freznel10/Chunky2040_rev2/Main Outline.dxf

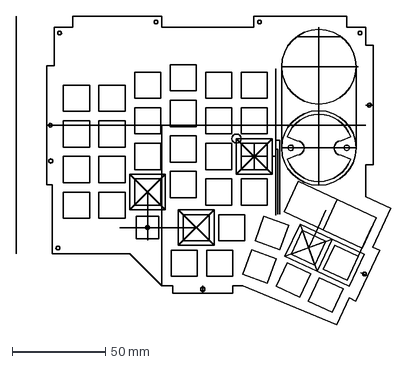
[picture p1: CAD file, 2023-04-12]
Main Outline.dxf
200.7 x 165.2 mm
