freznel10/Chunky2040_rev2/Assembly_final/Switch_Plate_Final.dxf

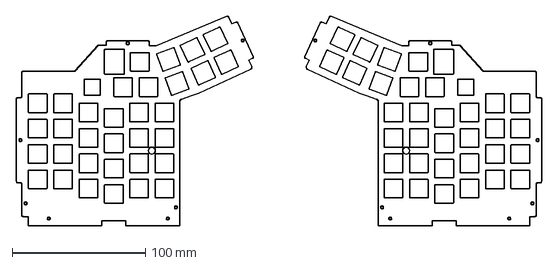
[picture p2: CAD file, 2023-04-12]
Assembly_final/Switch_Plate_Final.dxf
394.5 x 157.6 mm
