freznel10/Chunky2040_rev2/Assembly_final/Top_Right.step

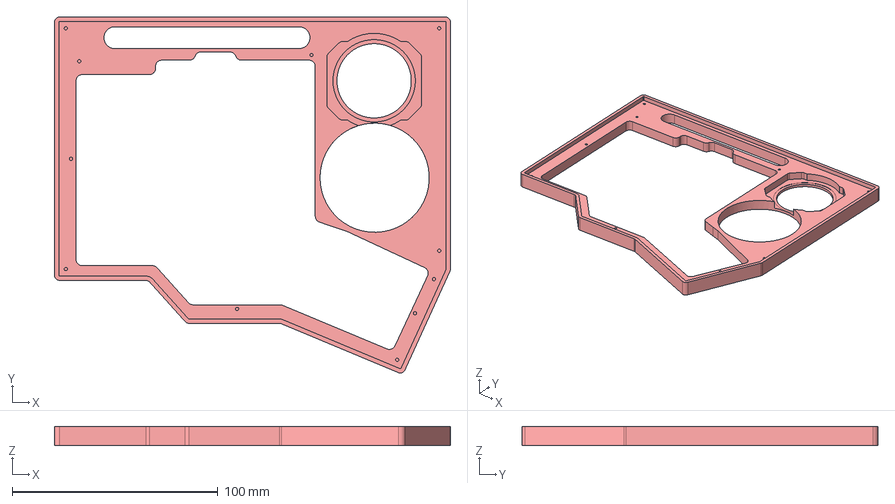
[picture p3: CAD file, 2023-04-12]
Assembly_final/Top_Right.step
192.3 x 172.8 x 9.30 mm
