freznel10/Chunky2040_rev2/SK8707-51.dxf

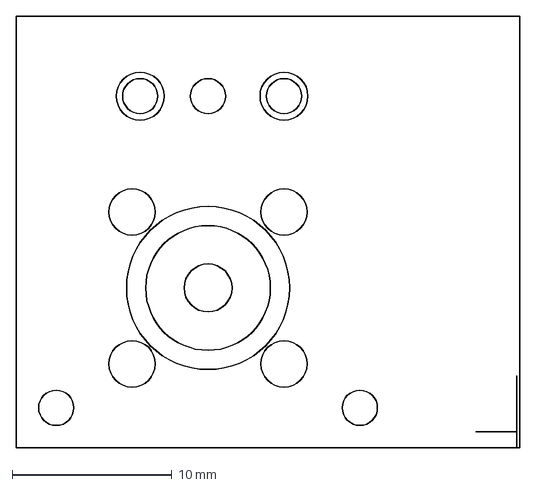
[picture p4: CAD file, 2023-04-12]
SK8707-51.dxf
31.5 x 27.0 mm
