freznel10/Chunky2040_rev2/Assembly_final/Bottom_Right.step

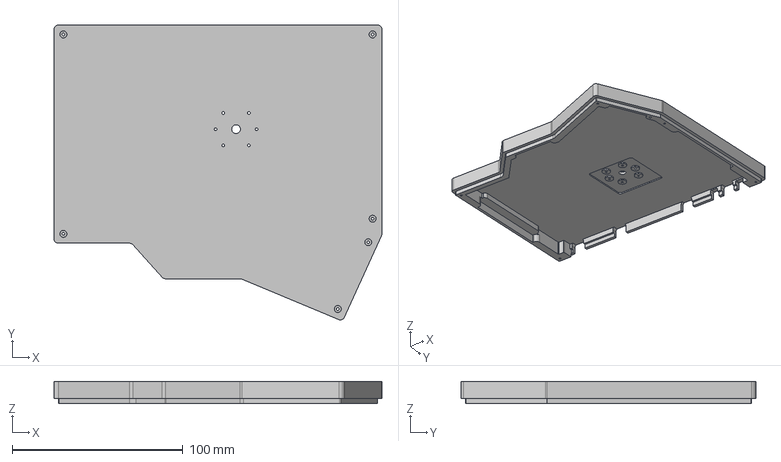
[picture p5: CAD file, 2023-04-12]
Assembly_final/Bottom_Right.step
192.3 x 172.8 x 13.1 mm
