freznel10/Chunky2040_rev2/Edge Cuts_v10.dxf

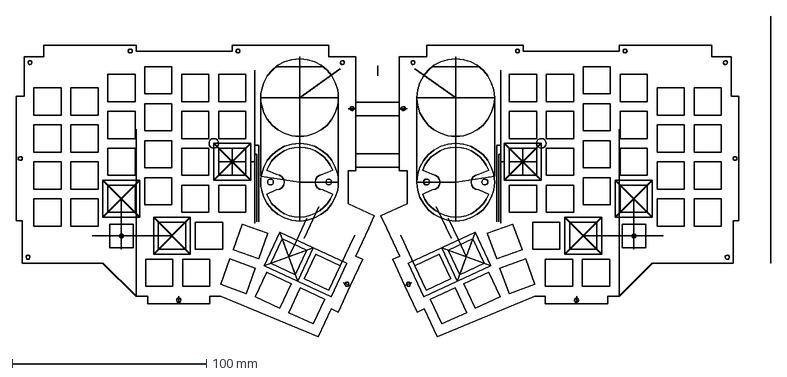
[picture p6: CAD file, 2023-04-12]
Edge Cuts_v10.dxf
388.5 x 165.2 mm
