freznel10/Chunky2040_rev2/Edge_Cuts_v6.dxf

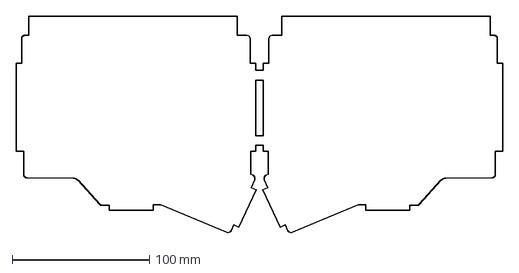
[picture p7: CAD file, 2023-04-12]
Edge_Cuts_v6.dxf
354.2 x 157.8 mm
