freznel10/Chunky2040_rev2/Badge_Sensor.dxf

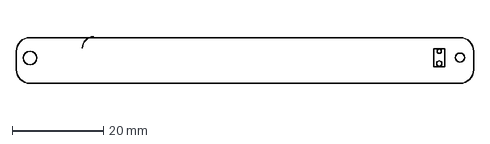
[picture p8: CAD file, 2023-04-12]
Badge_Sensor.dxf
100.0 x 10.2 mm
