freznel10/Chunky2040_rev2/GC9A01 v1.step

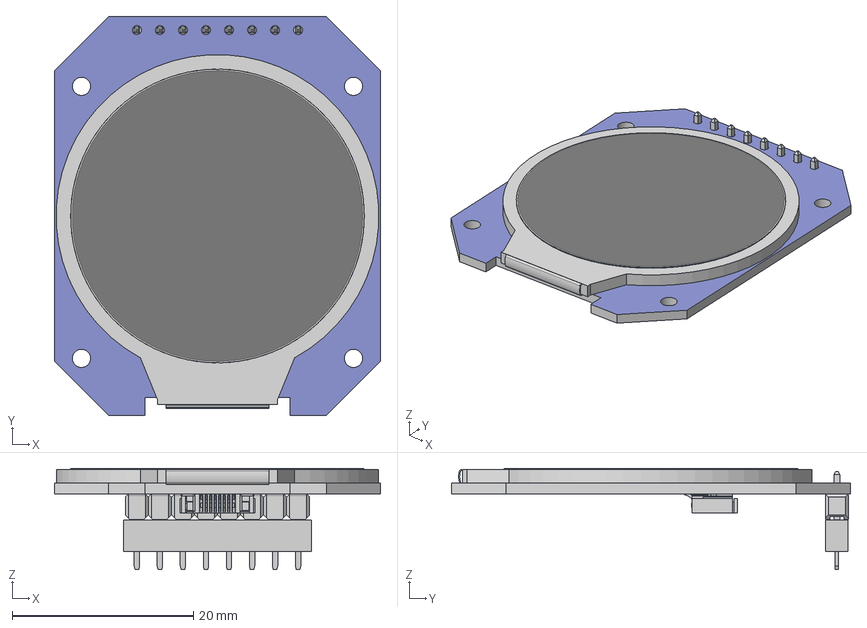
[picture p9: CAD file, 2023-04-12]
GC9A01 v1.step
36.0 x 44.0 x 11.2 mm
Header Socket 8-way v1
Pin Header 1x8 TH Pitch 2.54mm v1
FPC-8 v1 (1)
Screen1
Screen2
Screen Body (1)
