freznel10/Chunky2040_rev2/Edge_Guide_Scroll.dxf

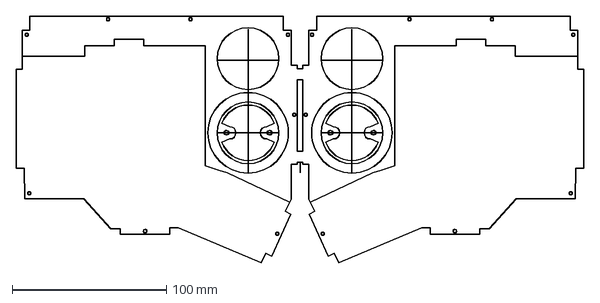
[picture p10: CAD file, 2023-04-12]
Edge_Guide_Scroll.dxf
368.2 x 159.8 mm
