freznel10/Chunky2040_rev2/T16_Scroll Wheel.step

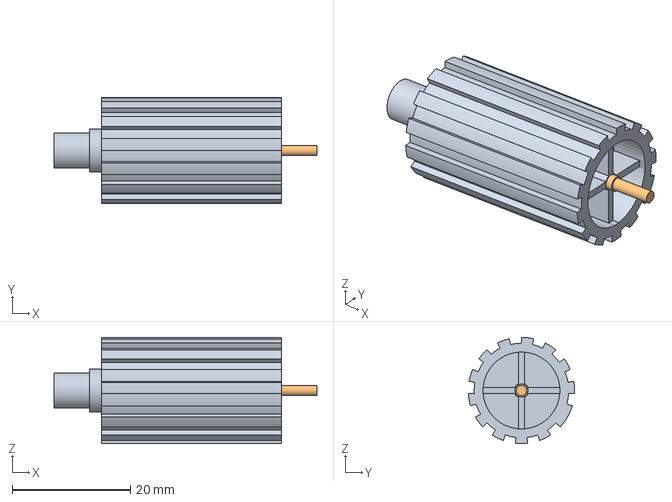
[picture p11: CAD file, 2023-04-12]
T16_Scroll Wheel.step
44.5 x 18.0 x 18.0 mm
