freznel10/Chunky2040_rev2/Switch.dxf

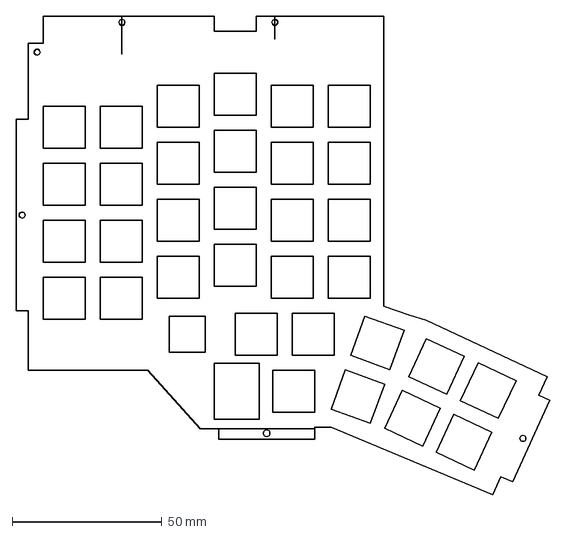
[picture p12: CAD file, 2023-04-12]
Switch.dxf
178.2 x 159.8 mm
