freznel10/Chunky2040_rev2/Fit Test.dxf

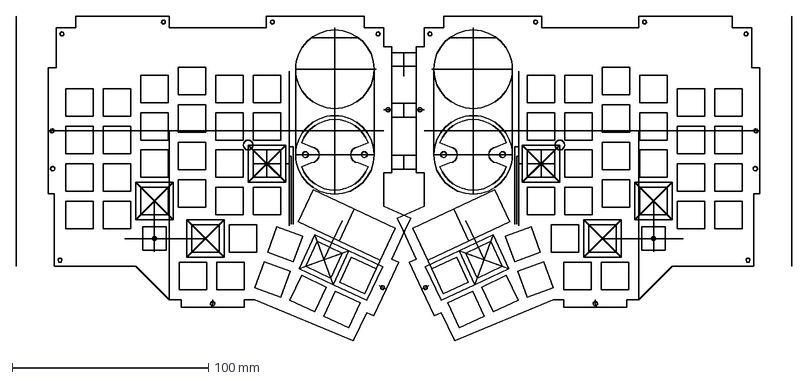
[picture p13: CAD file, 2023-04-12]
Fit Test.dxf
394.8 x 165.2 mm
