freznel10/Chunky2040_rev2/D65 gasket.dxf

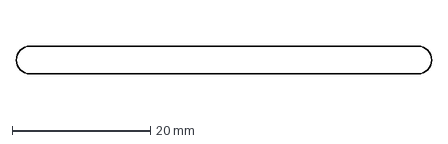
[picture p14: CAD file, 2023-04-12]
D65 gasket.dxf
60.0 x 4.00 mm
