freznel10/Chunky2040_rev2/Cover_Guide.dxf

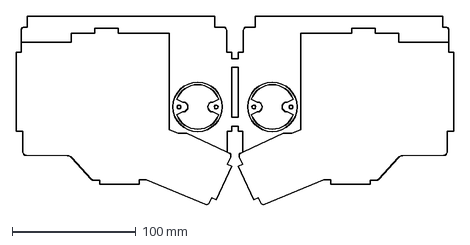
[picture p15: CAD file, 2023-04-12]
Cover_Guide.dxf
354.2 x 152.8 mm
