freznel10/Chunky2040_rev2/Outline_2.dxf

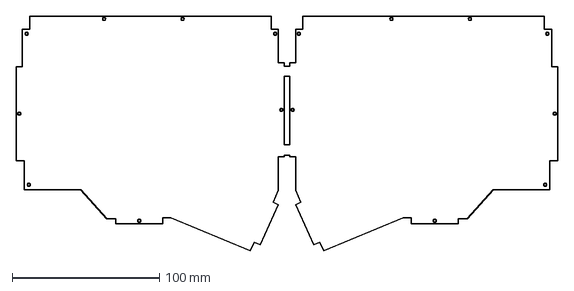
[picture p16: CAD file, 2023-04-12]
Outline_2.dxf
368.2 x 159.8 mm
