freznel10/Chunky2040_rev2/Final Outline.dxf

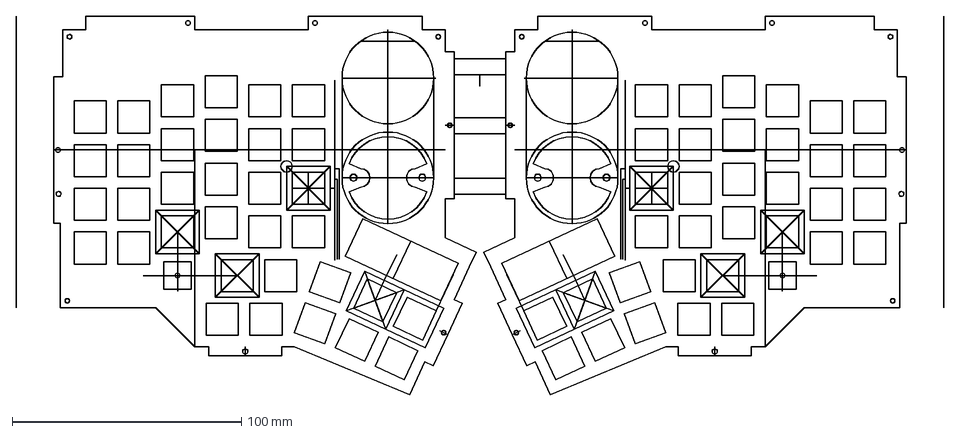
[picture p17: CAD file, 2023-04-12]
Final Outline.dxf
404.8 x 165.2 mm
