freznel10/Chunky2040_rev2/Scroll Wheel.step

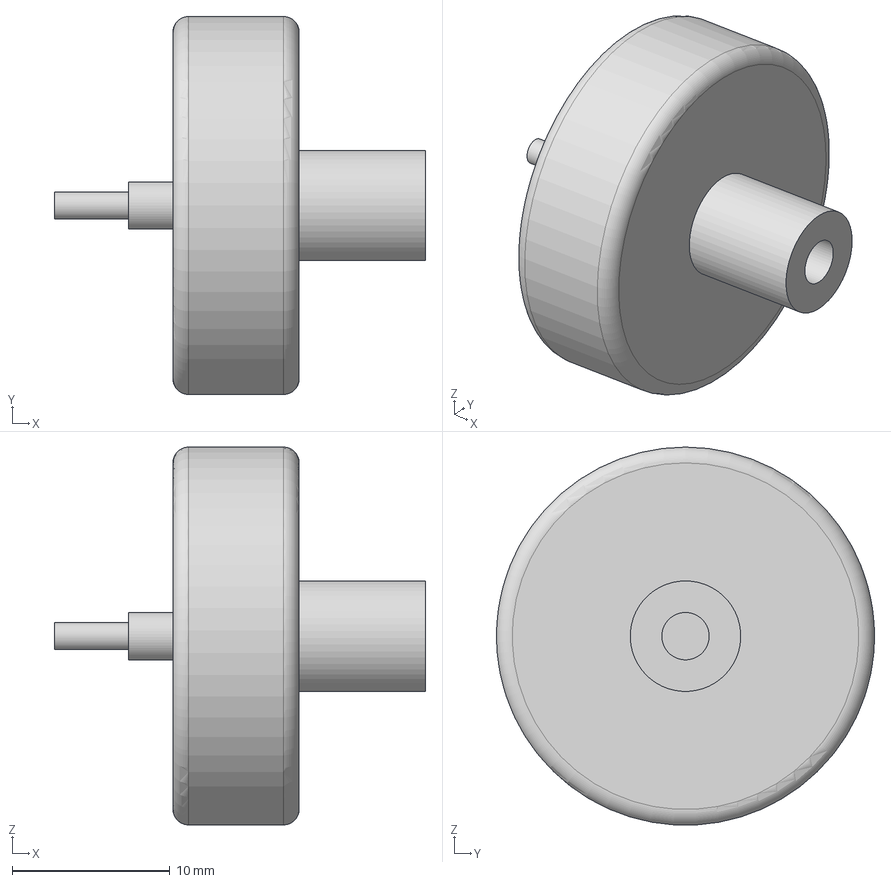
[picture p18: CAD file, 2023-04-12]
Scroll Wheel.step
23.5 x 23.9 x 23.9 mm
