freznel10/Chunky2040_rev2/Switch_Plate_REVERSIBLE.dxf

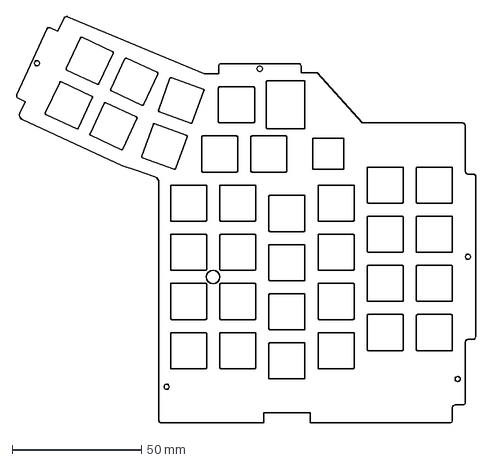
[picture p19: CAD file, 2023-04-12]
Switch_Plate_REVERSIBLE.dxf
178.0 x 157.6 mm
