freznel10/Chunky2040_rev2/Cutout_Draft.dxf

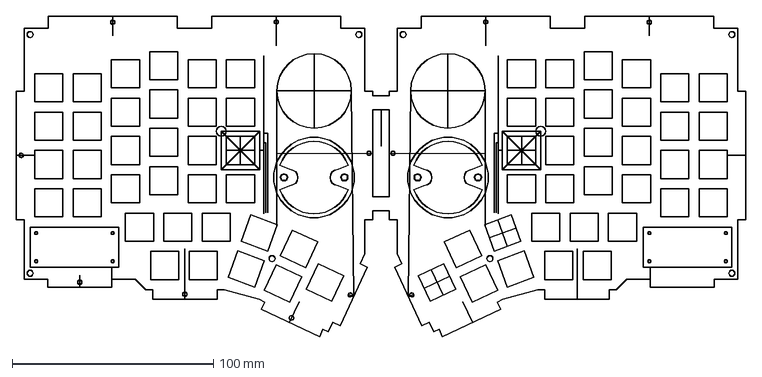
[picture p20: CAD file, 2023-04-12]
Cutout_Draft.dxf
362.7 x 159.1 mm
