freznel10/Chunky2040_rev2/final holder (1) v1.step

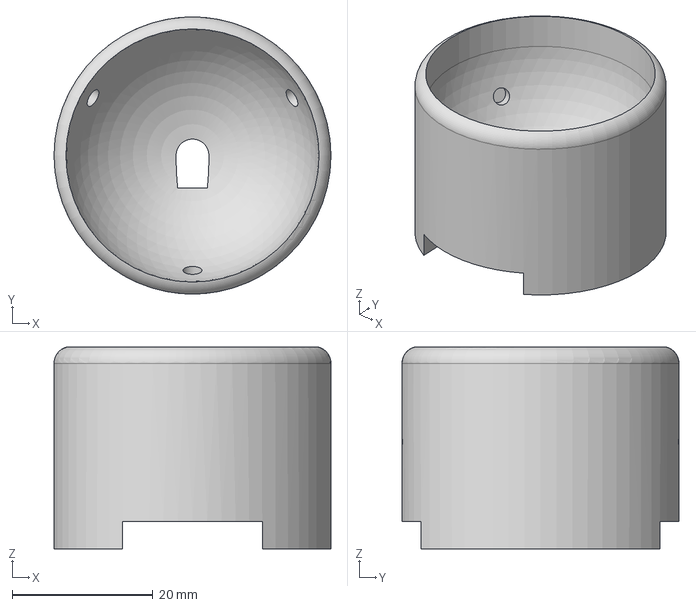
[picture p21: CAD file, 2023-04-12]
final holder (1) v1.step
39.4 x 39.4 x 28.7 mm
