freznel10/Chunky2040_rev2/Badge_Sensor_edit.dxf

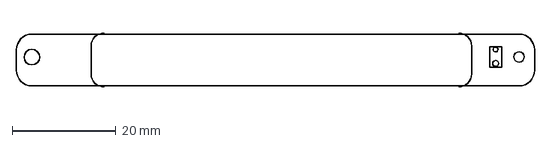
[picture p22: CAD file, 2023-04-12]
Badge_Sensor_edit.dxf
100.0 x 10.4 mm
