freznel10/Chunky2040_rev2/Edge Cuts.dxf

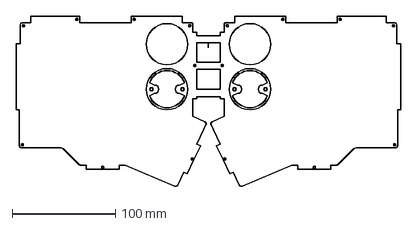
[picture p23: CAD file, 2023-04-12]
Edge Cuts.dxf
372.2 x 164.9 mm
