freznel10/Chunky2040_rev2/Chunky_M.dxf

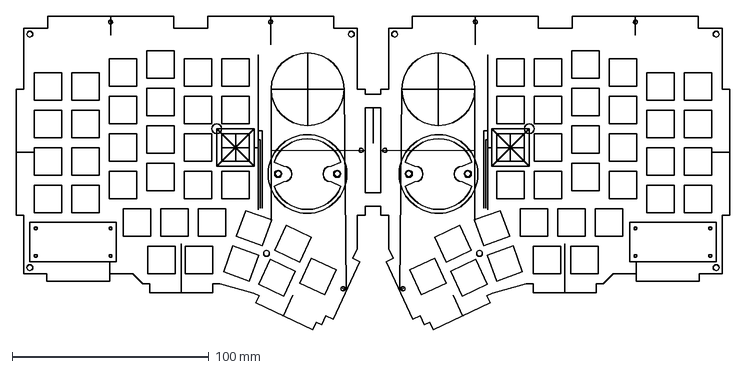
[picture p24: CAD file, 2023-04-12]
Chunky_M.dxf
362.7 x 159.1 mm
