freznel10/Chunky2040_rev2/Switch_Plate.step

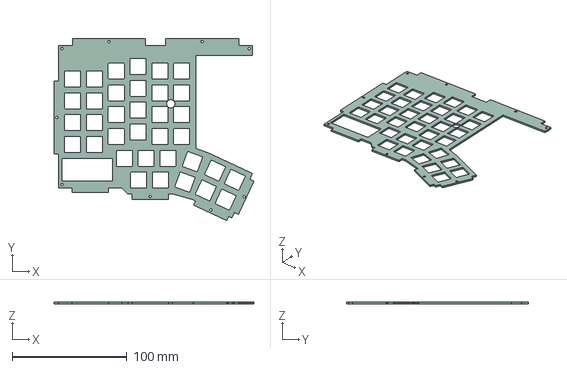
[picture p25: CAD file, 2023-04-12]
Switch_Plate.step
174.6 x 159.1 x 1.59 mm
