freznel10/Chunky2040_rev2/(list of files, cad)

Other CAD files:
Assembly_final/Bottom_Left.step
Assembly_final/Top_Case_Left_Final.step
Assembly_final/Top_Left.step
Assembly_final/Top_Case_RIght_Final.step
Top_Case.step
Bottom_Combined.f3d
D65 Gasket.f3d
Edge_Cuts_v2.dxf
Edge_Cuts_v3.dxf
Edge_Cuts_v4.dxf
Edge_Cuts_v5.dxf
Switch_Plate.f3d
Top_Case.f3d
