freznel10/Chunky2040_rev2/Printing Print Schematic.pdf

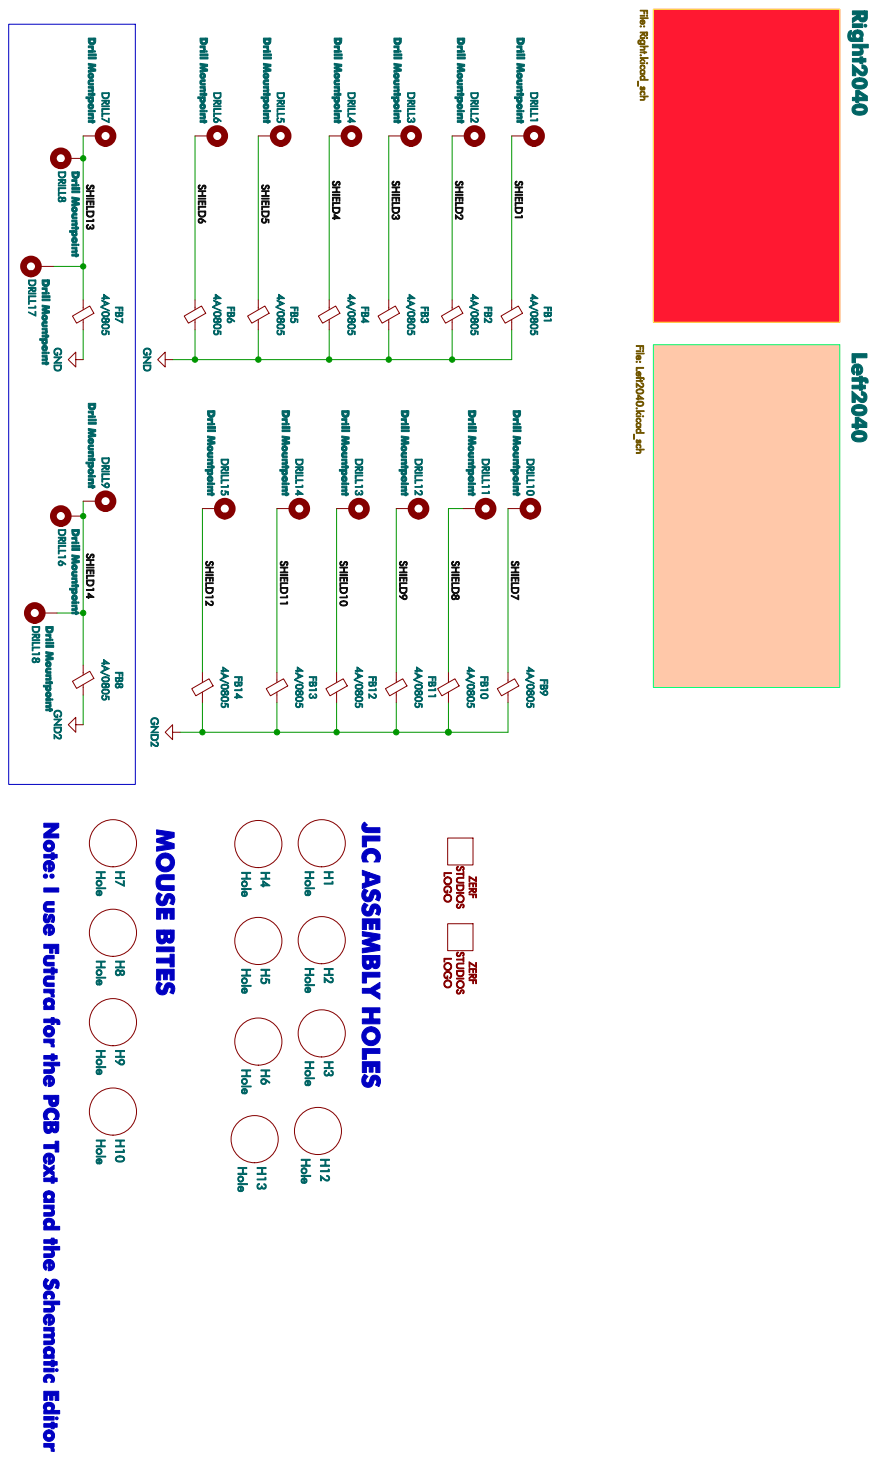
[picture p26: page 1]

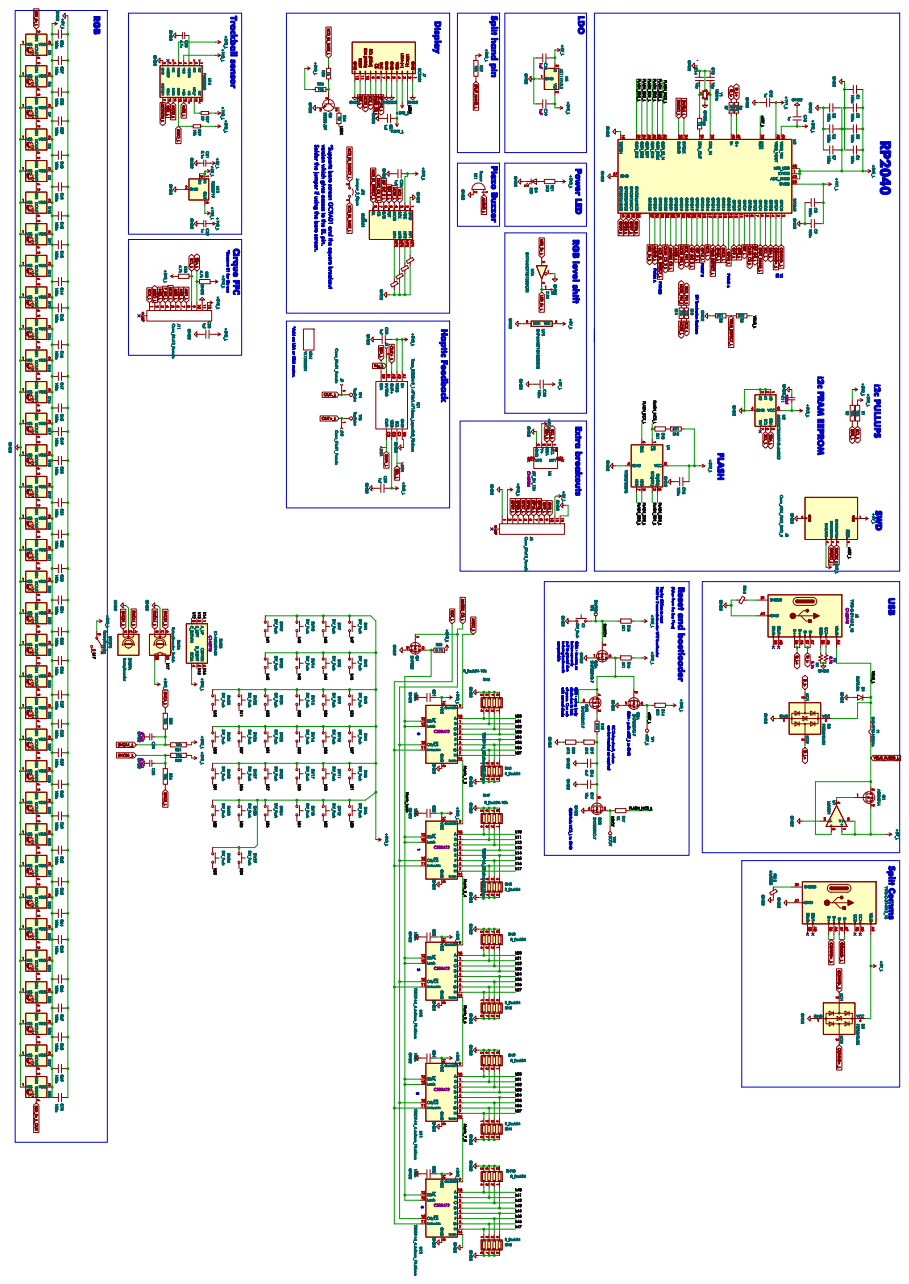
[picture p27: page 2]

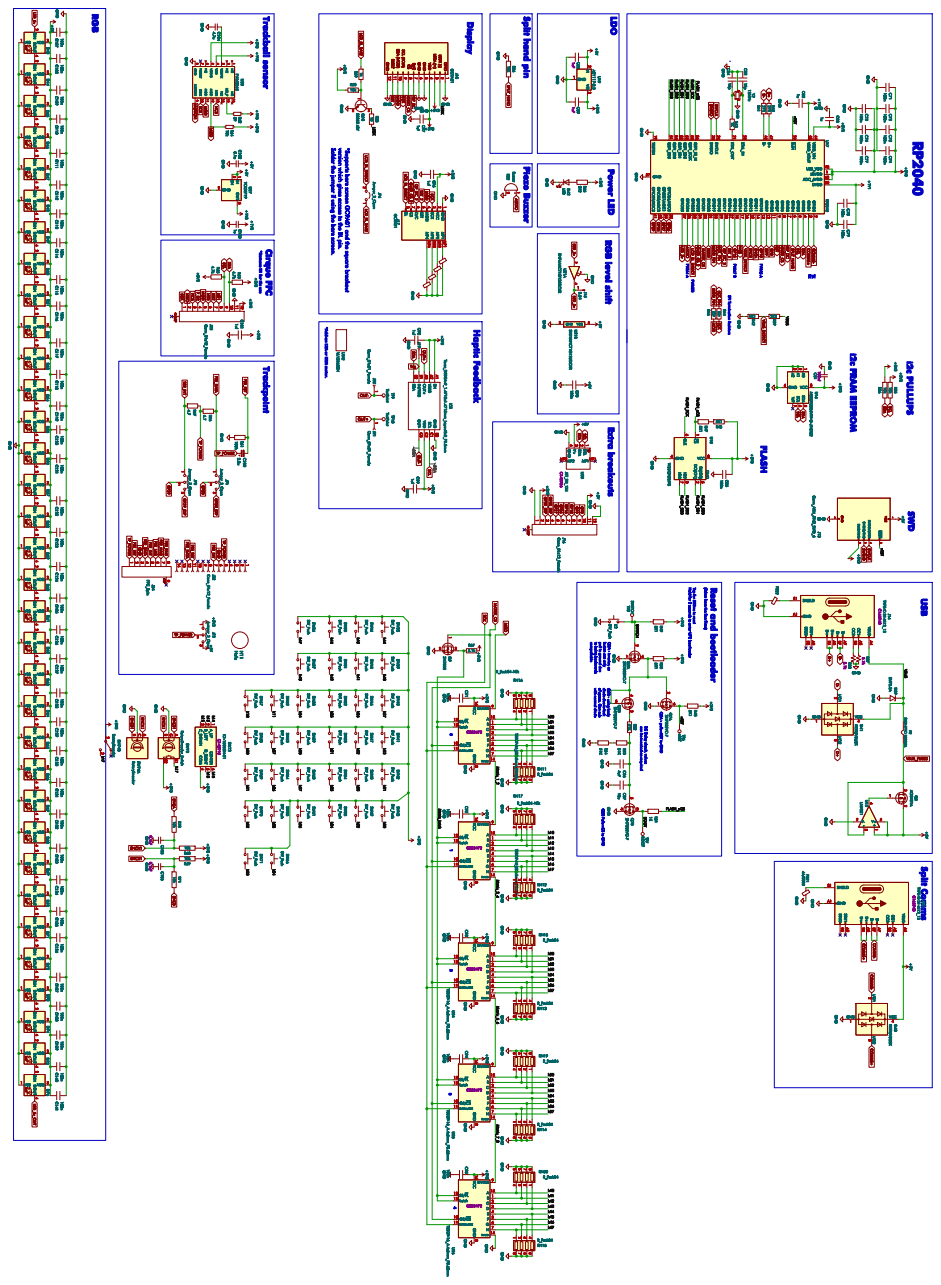
[picture p28: page 3]
