freznel10/Chunky2040_rev2/Draft Chunk2040 v 2 (c) freznel.pdf

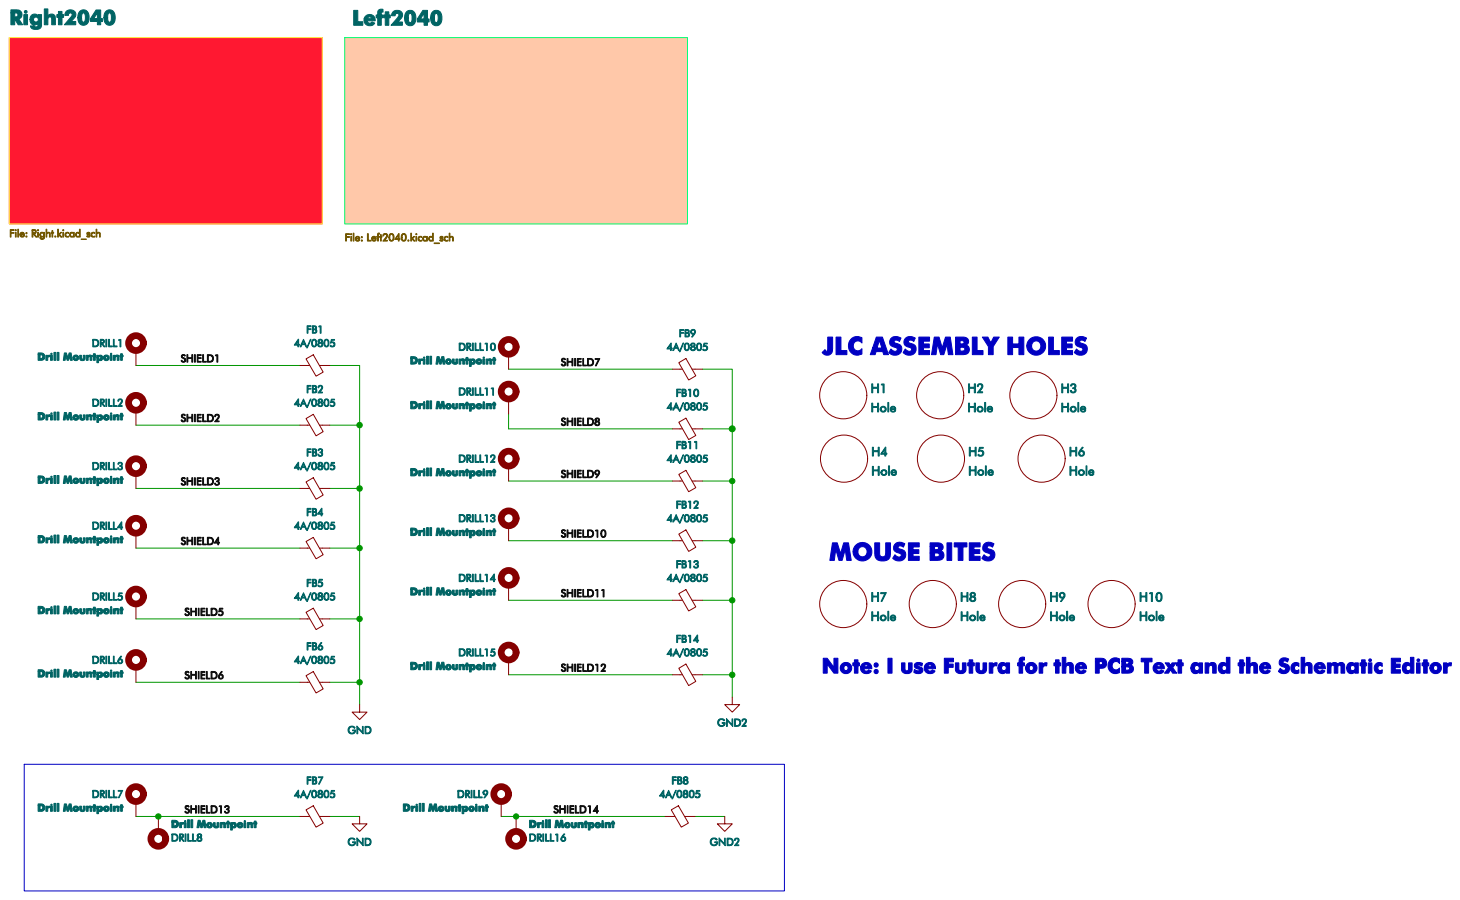
[picture p29: page 1]

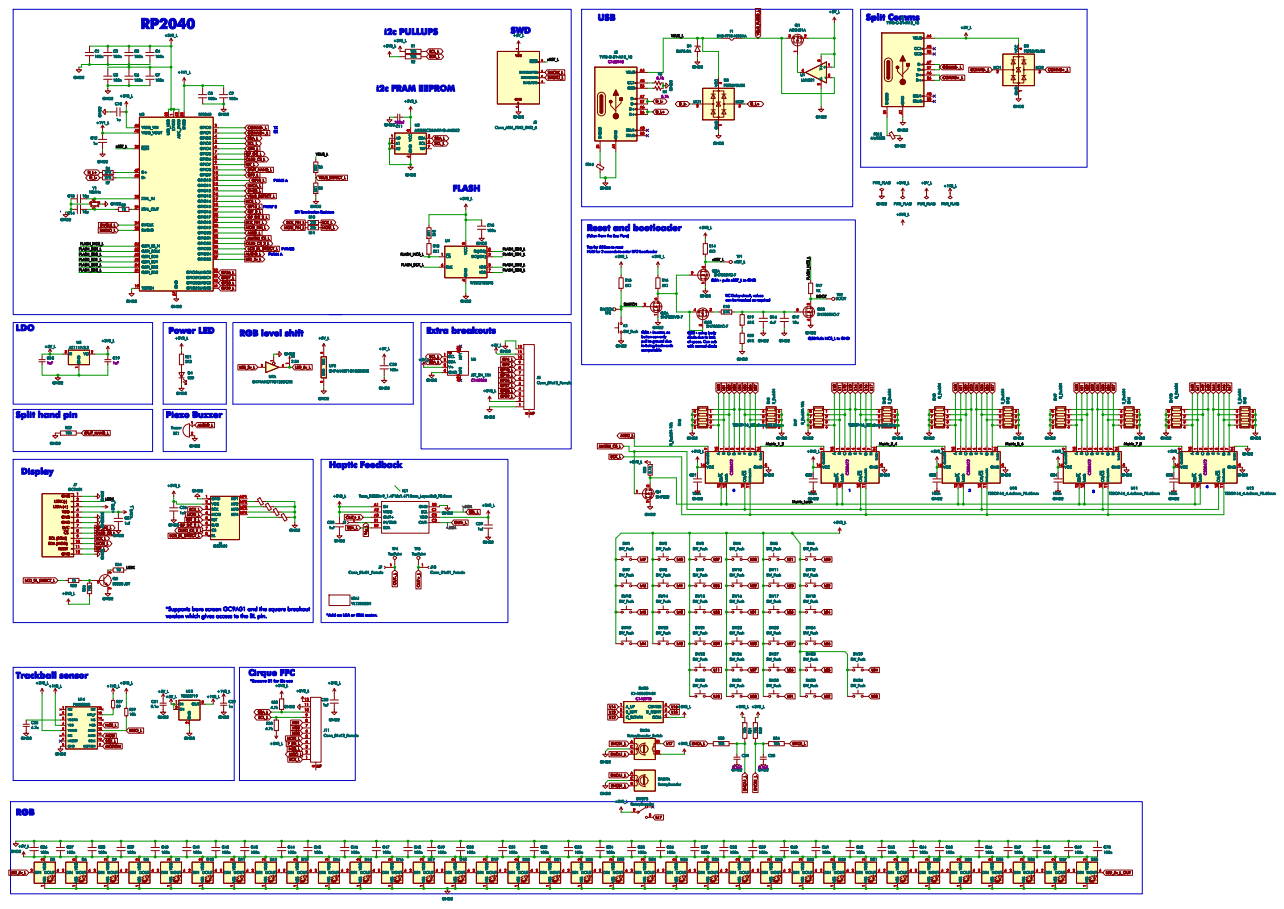
[picture p30: page 2]

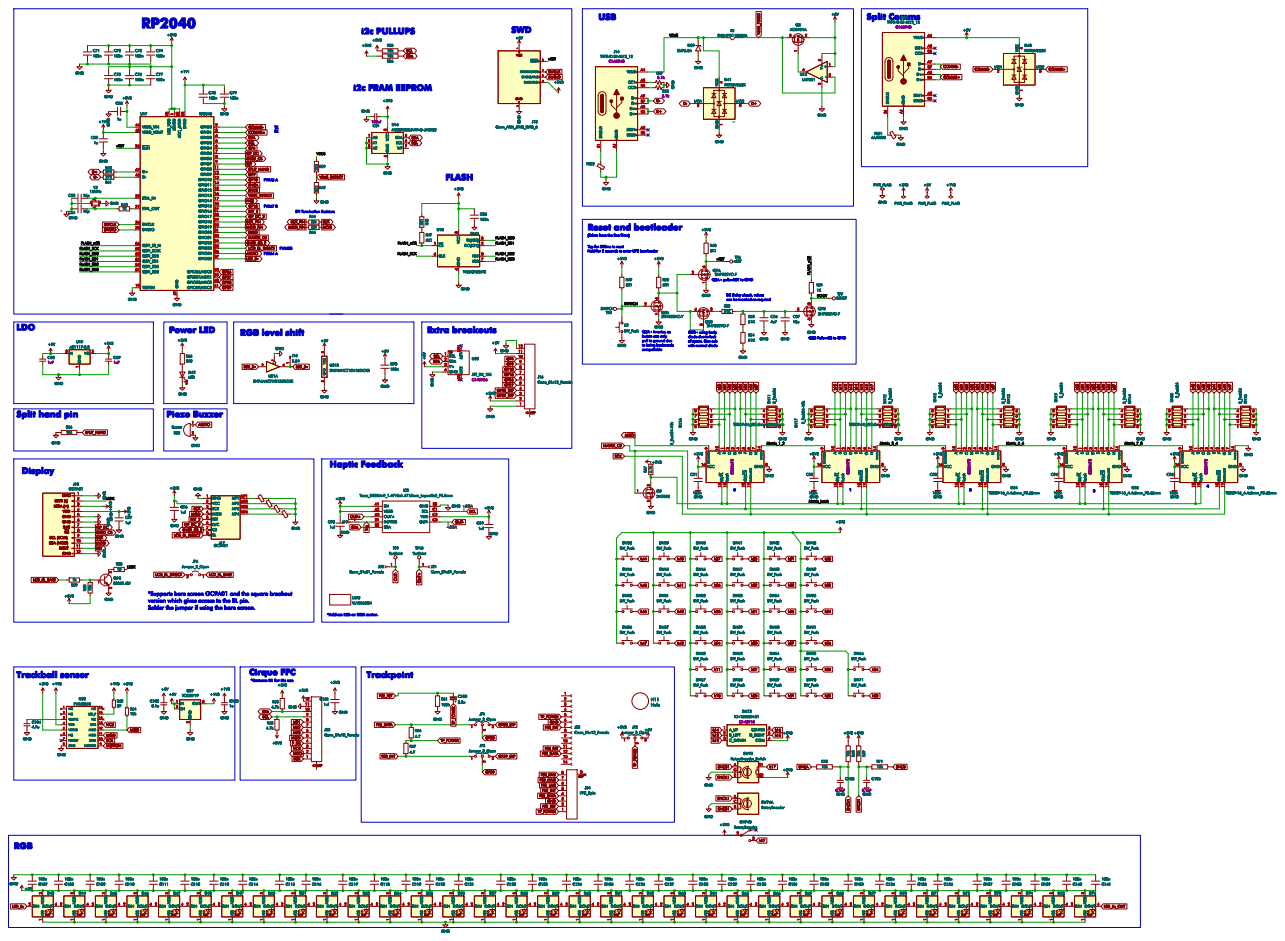
[picture p31: page 3]
