freznel10/Chunky2040_rev2/(list of files, drawings)

Other design files:
freerouting.dsn
