freznel10/Chunky2040_rev2/Chunky2040_rev3.kicad_sch

## KiCad design Chunky2040_rev3.kicad_sch (2023-04-12)

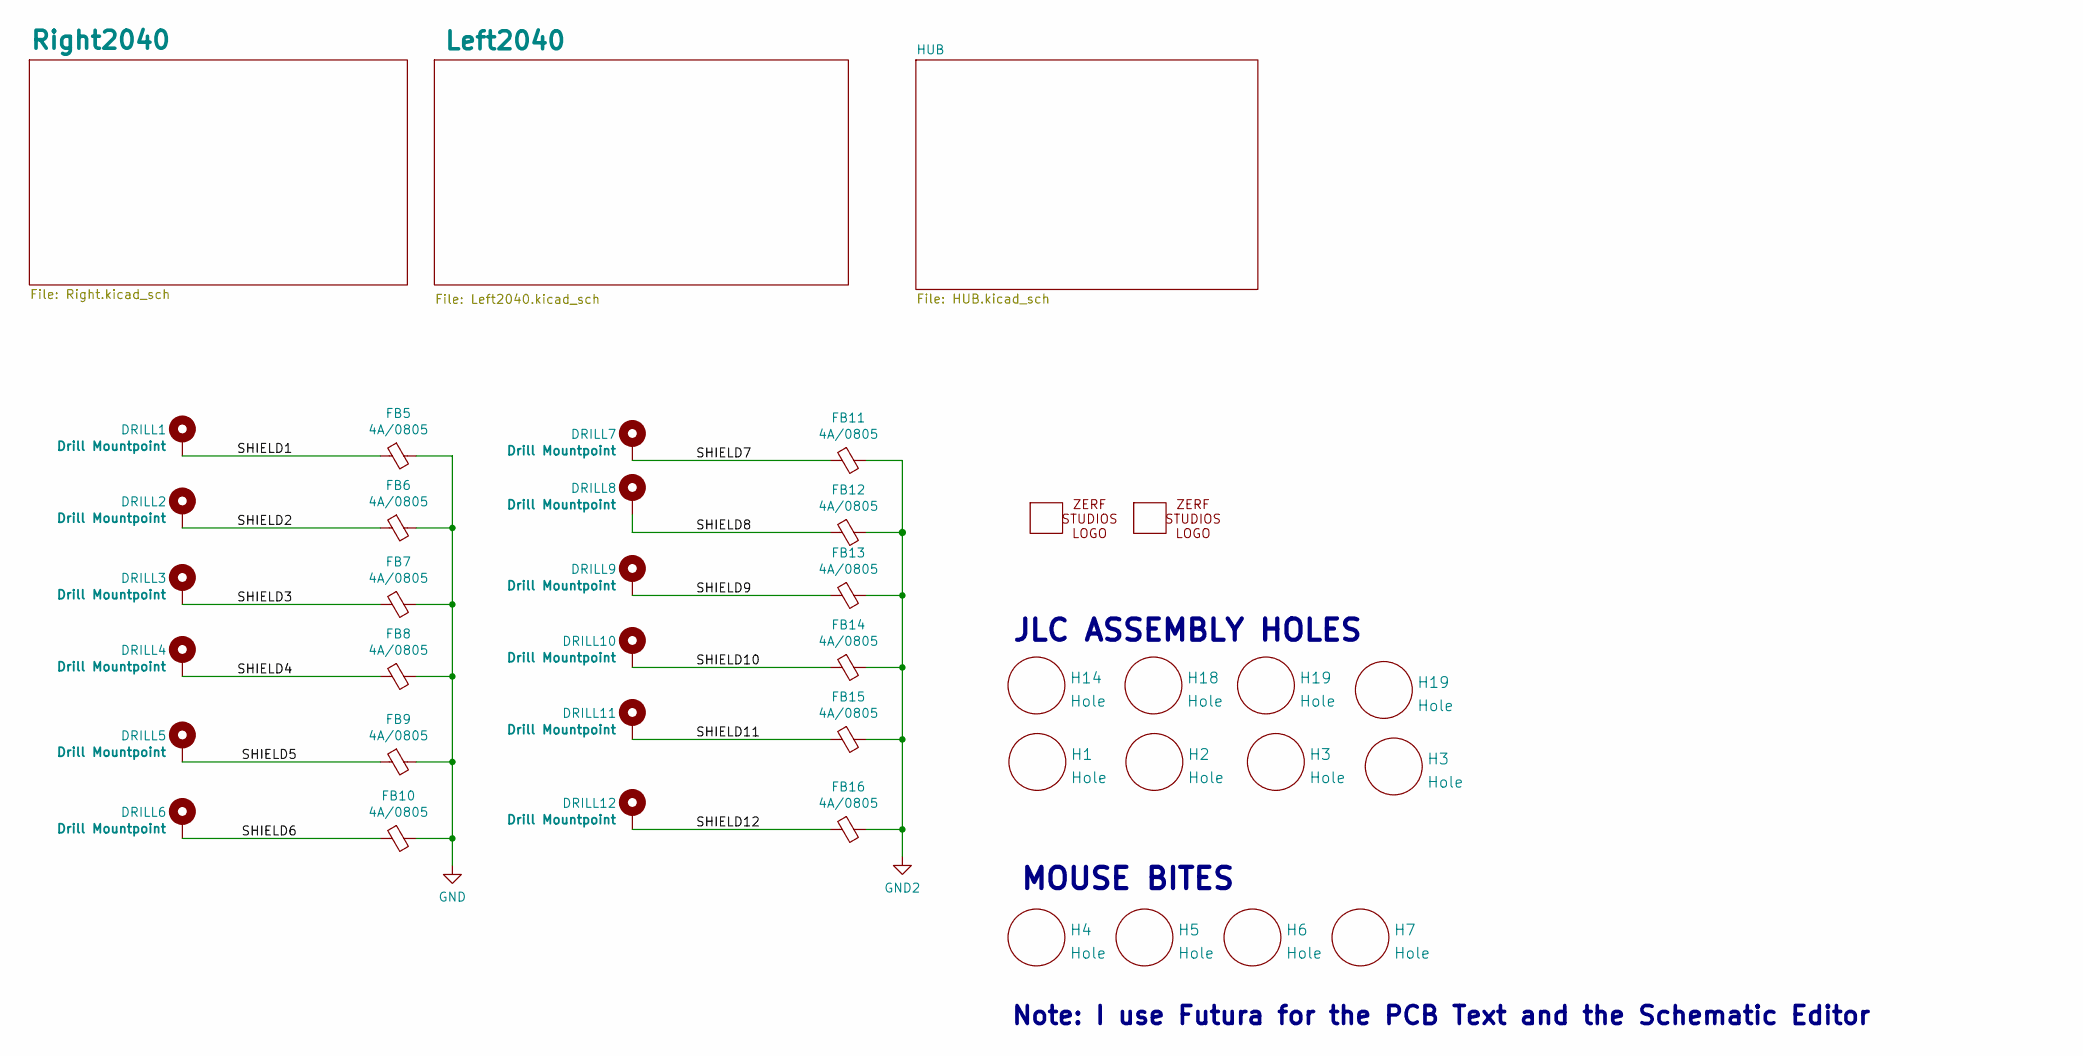
[picture p32: schematic Chunky2040_rev3.kicad_sch]

Parts:
DRILL1, DRILL2, DRILL7, DRILL8: Drill Mountpoint; MountingHole_3.2mm_M3_Pad_Via
DRILL3, DRILL4, DRILL5, DRILL6, DRILL9, DRILL10, DRILL11, DRILL12: Drill Mountpoint; MountingHole_2.2mm_M2_Pad_Via
FB5, FB6, FB7, FB8, FB9, FB10, FB11, FB12, FB13, FB14, FB15, FB16: 4A/0805; L_0805_2012Metric_Pad1.15x1.40mm_HandSolder; MPN UPZ2012D101-4R0TF; LCSC C370576
H1, H2, H3, H14, H18, H19: Hole; JLC_SMT_Assembly_Hole
H4, H5, H6, H7: Hole; breakaway-mousebites
LOGO: ZerfStudios_Logo; zerfstudios

Connections:
GND: FB5.2, FB6.2, FB7.2, FB8.2, FB9.2, FB10.2
GND2: FB11.2, FB12.2, FB13.2, FB14.2, FB15.2, FB16.2
SHIELD1: DRILL1.1, FB5.1
SHIELD2: DRILL2.1, FB6.1
SHIELD3: DRILL3.1, FB7.1
SHIELD4: DRILL4.1, FB8.1
SHIELD5: DRILL5.1, FB9.1
SHIELD6: DRILL6.1, FB10.1
SHIELD7: DRILL7.1, FB11.1
SHIELD8: DRILL8.1, FB12.1
SHIELD9: DRILL9.1, FB13.1
SHIELD10: DRILL10.1, FB14.1
SHIELD11: DRILL11.1, FB15.1
SHIELD12: DRILL12.1, FB16.1

Notes on the sheet:
JLC ASSEMBLY HOLES
MOUSE BITES
Note: I use Futura for the PCB Text and the Schematic Editor
