freznel10/Chunky2040_rev2/Left2040.kicad_sch

## KiCad design Left2040.kicad_sch (2023-04-12)

Schematic: Left2040.kicad_sch

Parts:
C1: 4.7uF; C_0603_1608Metric; MPN GRM188R6YA475KE15D; LCSC C76615
C2, C8, C11, C12, C16, C18, C20, C21, C22, C23, C29, C35, C36, C38, C60, C77, C78, C79, C80, C81, C82, C83, C84, C85, C86, C87, C88, C89, C90, C91, C99, C100, C101, C102, C103, C104, C105, C106, C107, C108, C109, C110, C111, C112, C113, C114, C115, C116, C117, C118, C119: 100nF; C_0402_1005Metric; MPN CL05B104KO5NNNC; LCSC C1525
C3: 15pF; C_0402_1005Metric; MPN 0402CG150J500NT; LCSC C1548
C4: 10pF; C_0805_2012Metric_Pad1.18x1.45mm_HandSolder; MPN CL21C100JCANNNC; LCSC C318752
C5, C25, C30, C98: 1uF; C_0603_1608Metric; MPN CL10A105KB8NNNC; LCSC C15849
C9: 10uF; C_0603_1608Metric; MPN C1608X5R1E475KT000E; LCSC C96446
C10: 1uF; C_0603_1608Metric; MPN CL10A105KA8NNNC; LCSC C5673
C13, C27, C28, C31, C32: 1uF; C_0402_1005Metric; MPN CL05A105KA5NQNC; LCSC C52923
C14: 4.7uF; C_0402_1005Metric; MPN CL05A475MP5NRNC; LCSC C23733
C19: 2.2uF; C_0402_1005Metric; MPN CL05A225KA5NUNC; LCSC C307418
C24: 100nF; C_0603_1608Metric; MPN CC0603KRX7R9BB104; LCSC C14663
C34: 4.7uF; C_0402_1005Metric; MPN CL05A475MP5NRNC; JLC Basic Y
C37: 10uF; C_0402_1005Metric; MPN CL05A106MQ5NUNC; JLC Basic Y
C92: 100uF; C_1210_3225Metric_Pad1.33x2.70mm_HandSolder; MPN TAJB107K006RNJ; LCSC C16133
C171, C172: 220pF; C_0805_2012Metric; MPN CC0805JRNPO9BN221; LCSC C107112
D1: ESDA25P35; 1610; MPN ESDA25P35; LCSC C1974707
D2: LED; C_0603_1608Metric_Pad1.08x0.95mm_HandSolder; MPN 19-217/BHC-ZL1M2RY/3T; LCSC C72041
D3: ESDA25P35; 1610; MPN ESDA25P35; LCSC C1974707; not fitted
D4: PRTR5V0U2X; SOT-143; MPN PRTR5V0U2X; LCSC C2827688
D5: D_Schottky; D_0402_1005Metric; MPN CDBQR0130L-HF; LCSC C2886014
D6, D12, D26, D27, D28, D29, D30, D31, D32, D33, D34, D35, D36, D37, D38, D39, D40, D43, D44, D45, D46, D47, D48, D49, D50, D51, D52, D53, D54, D55, D56, D57, D58, D59: SK6803Mini-E; Tonyu-SK6812MINI-E; PartNumber C524051
D81: BAT60A; SOD-323; MPN BAT60AE6327; LCSC C117485
F1: SMD-PPTC-1000MA; Fuse_1206_3216Metric; MPN KT8-1000SMD1206; LCSC C207216
FB1, FB2, FB14, FB15, FB16, FB17: 4A/0805; L_0805_2012Metric_Pad1.15x1.40mm_HandSolder; MPN UPZ2012D101-4R0TF; LCSC C370576
FB25: 1kΩ@100MHz; L_0805_2012Metric_Pad1.15x1.40mm_HandSolder; MPN HCB2012KF-102T15; LCSC C304322
H8: Hole; SK8707-smaller hole
IC1: STUSB4500BJR; BGA25C40P5X5_259X259X54; Manufacturer_Part_Number STUSB4500BJR; Mouser Part Number 511-STUSB4500BJR
IC2: Texas_DSBGA-9_1.4715x1.4715mm_Layout3x3_P0.5mm; Manufacturer_Part_Number DRV2605YZFT; Mouser Part Number 595-DRV2605YZFT
IC4, IC5, IC6: AP22615AWU-7; AP22615AWU7; Manufacturer_Part_Number AP22615AWU-7; Mouser Part Number 621-AP22615AWU-7
J12: Conn_01x01_Female; 1pin_conn
J14, J18: Conn_01x01_Female; 1X01_OVAL
J15, J16: xunpu; FPC-SMD_12P-P0.50_XUNPU_FPC-05FB-12PH20; MPN FPC-05FB-12PH20; LCSC C2856829
J17: Conn_ARM_JTAG_SWD_6
J19, J21: TYPE-C-31-M12_13; HRO-TYPE-C-31-M-12-mod; MPN TYPE-C-31-M-12; LCSC C165948
J20: 2.54; TestPoint_SMDPad_D1.0mm_NO_SILK
J24: FPC_8pin; FPC-SMD_8P-P0.50_XUNPU_FPC-05FB-8PH20; MPN FPC-05FB-8PH20; LCSC C2856828
J27: 5pin-breakout; PinHeader_1x5_P2.54mm_Vertical
J28: PEC11S-929F-S0015; PEC11S929FS0015; Manufacturer_Part_Number PEC11S-929F-S0015; Mouser Part Number 652-PEC11S929FS15
J32, J33: 78171-0004; PicoEZMate-Reinforced-Lite; Manufacturer Part Number 78171-0004; LCSC Part Number C588524
J36: GC9A01; GC9A01_Octagon_Breakout; LCSC N/A
JP1, JP2: JUMPER-SMT_2_NC_TRACE_NO-SILK; SMT-JUMPER_2_NC_TRACE_NO-SILK
JP4: Jumper_2_Open; JUMPER_SMD_2DUB
JP6: Mess_Up_Jumper; SolderJumper-2_P1.3mm_Open_Pad1.0x1.5mm
K1: SW_Push; Panasonic_EVQPUL_EVQPUC; LCSC C397351
LRA2: VL120628H; MPN VL120628H
LS1: Speaker; KLJ-7525-3627; MPN KLJ-7525-3627; LCSC C189208
Q1: SSM6J507NU; UDFN6B; MPN SSM6J507NU; LCSC C146318
Q2, Q3: 2N7002VC-7; SOT-563; MPN 2N7002V; JLC Basic N
Q4: AO3401A; SOT-23; MPN AO3401A; LCSC C347476
Q7: 2N7002; SOT-23; MPN 2N7002; LCSC C8545
Q8: S8050 J3Y; SOT-23; MPN S8050 J3Y; LCSC C2146
R1, R5, R34, R63: 1k; R_0402_1005Metric; MPN 0402WGF1001TCE; LCSC C11702
R2, R22, R23, R26, R61: 5.1k; R_0402_1005Metric; MPN 0402WGF5101TCE; LCSC C25905
R3, R4: 27r; R_0402_1005Metric; MPN 0402WGF270JTCE; LCSC C25100
R6: 39r; R_0402_1005Metric; MPN 0402WGF390JTCE; LCSC C25110
R7, R64: 10k; R_0402_1005Metric; MPN 0402WGF1002TCE; LCSC C25744
R8: 100Ω; R_0402_1005Metric; MPN RC0402FR-07100RL; LCSC C106232
R9: 470; R_0402_1005Metric; MPN CR0402F470RQ10Z; LCSC C881342
R11: 2k2; R_0402_1005Metric; MPN 0402WGF2201TCE; JLC Basic Y
R12: 5.1k; R_0402_1005Metric; MPN 0402WGF5101TCE; JLC Basic Y
R13, R14: 4.7k; R_0402_1005Metric; MPN 0402WGF4701TCE; LCSC C25900; not fitted
R15: 100k; R_0402_1005Metric; MPN RC0402FR-07100KL; LCSC C25741
R17: 2k2; R_0402_1005Metric; MPN 0402WGF2201TCE; LCSC C25879
R18, R20: 4.7k; R_0402_1005Metric; MPN 0402WGF4701TCE; LCSC C25900
R21, R30, R31, R32, R33: 10k; R_0402_1005Metric; MPN 0402WGF1002TCE; LCSC Part C328298
R24: 5.1k; R_0402_1005Metric; MPN 0402WGF5101TCE; LCSC C25905; not fitted
R27, R28, R29: 51K; R_0402_1005Metric; MPN 0402WGF5102TCE; JLC Basic Y
R65: 10r; R_0603_1608Metric_Pad0.98x0.95mm_HandSolder; MPN 0603WAJ0100T5E; LCSC C25202
R70: 6.8k; R_0402_1005Metric; MPN RC0402FR-076K8L; LCSC C93940
R104: 3313J-1-103E; TRIM_3313J-1-103E; PARTREV 08/19; LCSC C124616
RN1, RN2, RN3, RN4, RN5, RN11, RN12, RN13, RN14, RN15: R_Pack04-10k; R_Array_Concave_4x0603; MPN 667-EXB-V8V512JV; LCSC C3033965
SW1, SW2, SW3, SW4, SW5, SW6, SW7, SW8, SW9, SW10, SW11, SW12, SW13, SW14, SW15, SW16, SW17, SW18, SW19, SW20, SW21, SW22, SW23, SW24, SW25, SW26, SW27, SW28, SW29, SW30, SW31, SW32, SW71, SW72: SW_Push; MX_ChocV1V2_HS (2023)
SW33: K1-1506SN-01; MPN K1-1506SN-01; LCSC C145910
SW34: RotaryEncoder_Switch; EC50A0920404
SW35: RotaryEncoder; Apls EC10E1220503 (11 mm) - assembly_corrected; not fitted
TP2, TP4: TestPoint; TESTPOINT_PAD_2MM
TP5: SWITCH; TestPoint_SMDPad_D1.0mm_NO_SILK
TP6: nRST; TestPoint_SMDPad_D1.0mm_NO_SILK
TP7: BOOT; TestPoint_SMDPad_D1.0mm_NO_SILK
U1: W25Q128JVS; SOIC-8_5.23x5.23mm_P1.27mm; MPN W25Q128JVS; LCSC C97521
U2: RP2040; RP2040-QFN-56; MPN RP2040; LCSC C2040
U3: PWM3360; DIP-16_W10.16mm-rev
U4: TCR2EF19; SOT-23-5; LCSC C146366
U5: MB85RC256VPF-G-JNERE2; SOIC8_208MIL; MPN MB85RC256VPF-G-JNERE2; LCSC C126728
U6: AZ1117-3.3; SOT-223-3_TabPin2; MPN AZ1117H-3.3TRE1; LCSC C92517
U8: SN74AHCT1G125DCKR; SOT-353_SC-70-5_Handsoldering; MPN SN74AHCT1G125DCKR; LCSC C350557
U9: LMV321; SOT-23-5; MPN LMV321; LCSC C395459
U10, U11, U12, U13, U14: TSSOP-16_4.4x5mm_P0.65mm; MPN MC74HC589ADTR2G; LCSC C233472
U31: 74AHC04; TSSOP-14_4.4x5mm_P0.65mm; MPN 74HC04PW,118; LCSC C80000
U32: XW06A; SOP-16_3.9x9.9mm_P1.27mm; LCSC C389301
U35: PAM8302AASCR; MSOP-8_3x3mm_P0.65mm; MPN PAM8302AASCR; LCSC C113367
Y1: 12MHz; Crystal_SMD_2520-4Pin_2.5x2.0mm; MPN 2TJ412000HYGBC; LCSC C2149204
Y2: X322512MSB4SI 12Mhz; Crystal_SMD_3225-4Pin_3.2x2.5mm; MPN X322512MSB4SI; LCSC C9002

Connections:
+1V1_L: C10.1, C22.1, C23.1, U2.23 (DVDD), U2.45 (VREG_VOUT), U2.50 (DVDD)
+1V8_L: C25.1, R6.1, U3.4 (VDD), U4.5 (OUT)
+3V3_L: C1.1, C2.1, C2.2, C5.1, C8.1, C9.1, C9.2, C11.1, C12.1, C13.2, C16.1, C18.1, C19.1, C19.2, C20.1, C27.1, C29.2, C30.1, C31.1, C32.1, C36.1, C90.1, C91.1, C92.1, C98.1, C119.2, IC2.A1 (EN), IC2.A2 (VREG), IC2.C2 (VDD), J15.3, J15.4, J15.11, J16.12, J17.6 (SWO/TDO), J19.2, J24.8, J28.D1 (COM), J33.3, J36.2 (VCC), R1.1, R7.1, R13.1, R14.1, R14.2, R15.1, R17.1, R18.1, R20.2, R21.1, R22.1, R23.1, R24.2, R26.1, R31.1, R32.1, R61.2, R64.1, R70.1, R70.2, SW1.1, SW2.1, SW3.1, SW4.1, SW5.2, SW6.2, SW7.2, SW8.2, SW9.1, SW10.1, SW11.1, SW12.1, SW13.1, SW14.1, SW15.1, SW16.1, SW17.2, SW18.2, SW19.2, SW20.2, SW21.1, SW22.1, SW23.1, SW24.1, SW25.1, SW26.2, SW27.1, SW28.2, SW29.1, SW30.2, SW31.1, SW32.2, SW33.4 (COM), SW35.2, SW71.1, SW72.1, U1.8 (VCC), U2.1 (IOVDD), U2.10 (IOVDD), U2.22 (IOVDD), U2.33 (IOVDD), U2.42 (IOVDD), U2.44 (VREG_VIN), U2.48 (USB_VDD), U2.49 (IOVDD), U3.5 (VDDIO), U5.8 (VCC), U6.2 (VO), U10.16 (VCC), U11.16 (VCC), U12.16 (VCC), U13.16 (VCC), U14.16 (VCC), U31.14 (VCC), U32.16 (VDD), U35.6 (VDD)
+5V_L: C2.1, C21.1, C24.2, C28.1, C60.2, C77.2, C78.2, C79.2, C80.2, C81.2, C82.2, C83.2, C84.2, C85.2, C86.2, C87.2, C88.2, C89.2, C92.1, C99.2, C100.2, C101.2, C102.2, C103.2, C104.2, C105.2, C106.2, C107.2, C108.2, C109.2, C110.2, C111.2, C112.2, C113.2, C114.2, C115.2, C116.2, C117.2, C118.2, D6.1 (VDD), D12.1 (VDD), D26.1 (VDD), D27.1 (VDD), D28.1 (VDD), D29.1 (VDD), D30.1 (VDD), D31.1 (VDD), D32.1 (VDD), D33.1 (VDD), D34.1 (VDD), D35.1 (VDD), D36.1 (VDD), D37.1 (VDD), D38.1 (VDD), D39.1 (VDD), D40.1 (VDD), D43.1 (VDD), D44.1 (VDD), D45.1 (VDD), D46.1 (VDD), D47.1 (VDD), D48.1 (VDD), D49.1 (VDD), D50.1 (VDD), D51.1 (VDD), D52.1 (VDD), D53.1 (VDD), D54.1 (VDD), D55.1 (VDD), D56.1 (VDD), D57.1 (VDD), D58.1 (VDD), D59.1 (VDD), IC6.1 (OUT), J17.1 (VCC), J32.1, U4.1 (IN), U4.3 (EN), U6.3 (VI), U8.5 (VCC), U9.11 (VDD5)
ADDR0: IC1.D3 (ADDR0), JP1.2, R14.1
ADDR1: IC1.D2 (ADDR1), JP2.2, R15.2
ALERT: IC1.B2 (ALERT), J27.3
ATTACH: D2.1 (K), IC1.E2 (ATTACH)
AUDIO: R104.3, U2.36 (GPIO24)
BOOT: Q3.3 (D), R34.2, TP7.1
CC_1: D2.1 (K), IC1.B4 (CC1DB), IC1.B5 (CC1), J19.A5 (CC1), R24.2
CC_2: D2.2 (A), IC1.C4 (CC2DB), IC1.C5 (CC2), J19.B5 (CC2), R24.2
COMMS+: D1.3 (I/O2), J21.A6 (D+), J21.B6 (D+), U2.3 (GPIO1)
COMMS-: D1.2 (I/O1), J21.A7 (D-), J21.B7 (D-), U2.2 (GPIO0)
D2+: D4.3 (I/O2), J19.A6 (D+), J19.B6 (D+), U9.6 (DP2)
D2-: D4.2 (I/O1), J19.A7 (D-), J19.B7 (D-), U9.5 (DM2)
D3+: D4.3 (I/O2), J19.A6 (D+), J19.B6 (D+), U9.4 (DP3)
D3-: D4.2 (I/O1), J19.A7 (D-), J19.B7 (D-), U9.3 (DM3)
D4+: J32.3, U9.2 (DP4)
D4-: J32.2, U9.1 (DM4)
ENCA: R30.1, U2.14 (GPIO11)
ENCA1: C35.1, J28.A1 (CCW), R30.2, R31.2, SW35.A
ENCB: R33.2, U2.15 (GPIO12)
ENCB1: C38.1, J28.B1 (CW), R32.2, R33.1, SW35.B
ENCC: R30.1, U2.39 (GPIO27/ADC1)
ENCC1: C35.1, R30.2, R31.2, SW34.A
ENCD: R33.2, U2.38 (GPIO26/ADC0)
ENCD1: C38.1, R32.2, R33.1, SW34.B
FAULT: IC4.3 (FLG), R21.1
FAULT_2: IC5.3 (FLG), R21.1
FAULT_3: IC6.3 (FLG), R21.1
FLASH_NCS: R2.2, R34.1, U1.1 (~CS), U2.56 (QSPI_SS_N)
FLASH_SCK: U1.6 (CLK), U2.52 (QSPI_SCLK)
FLASH_SD0: U1.5 (DI(IO0)), U2.53 (QSPI_SD0)
FLASH_SD1: U1.2 (DO(IO1)), U2.55 (QSPI_SD1)
FLASH_SD2: U1.3 (IO2), U2.54 (QSPI_SD2)
FLASH_SD3: U1.7 (IO3), U2.51 (QSPI_SD3)
GND2: C1.2, C2.1, C2.2, C3.1, C4.1, C5.2, C8.2, C9.1, C9.2, C10.1, C10.2, C11.2, C12.2, C13.1, C13.2, C14.2, C16.2, C18.2, C19.2, C20.2, C21.2, C22.2, C23.2, C24.1, C25.2, C27.2, C28.2, C29.1, C30.2, C31.2, C32.2, C34.2, C35.2, C36.2, C37.2, C38.2, C60.1, C77.1, C78.1, C79.1, C80.1, C81.1, C82.1, C83.1, C84.1, C85.1, C86.1, C87.1, C88.1, C89.1, C90.2, C91.2, C92.2, C98.2, C99.1, C100.1, C101.1, C102.1, C103.1, C104.1, C105.1, C106.1, C107.1, C108.1, C109.1, C110.1, C111.1, C112.1, C113.1, C114.1, C115.1, C116.1, C117.1, C118.1, C119.1, C171.2, C172.2, D1.1 (GND), D1.2 (I/O1), D2.1 (K), D2.3 (A), D3.2 (A), D4.1 (GND), D6.3 (VSS), D12.3 (VSS), D26.3 (VSS), D27.3 (VSS), D28.3 (VSS), D29.3 (VSS), D30.3 (VSS), D31.3 (VSS), D32.3 (VSS), D33.3 (VSS), D34.3 (VSS), D35.3 (VSS), D36.3 (VSS), D37.3 (VSS), D38.3 (VSS), D39.3 (VSS), D40.3 (VSS), D43.3 (VSS), D44.3 (VSS), D45.3 (VSS), D46.3 (VSS), D47.3 (VSS), D48.3 (VSS), D49.3 (VSS), D50.3 (VSS), D51.3 (VSS), D52.3 (VSS), D53.3 (VSS), D54.3 (VSS), D55.3 (VSS), D56.3 (VSS), D57.3 (VSS), D58.3 (VSS), D59.3 (VSS), FB1.1, FB1.2, FB2.2, FB14.2, FB15.2, FB16.2, FB17.2, IC1.B1 (VSYS), IC1.E3 (GND), IC1.E4 (DISCH), IC2.B3 (GND), IC4.2 (GND), IC5.2 (GND), IC6.2 (GND), J15.1, J15.5, J15.6, J15.12, J15.13 (MP1), J15.14 (MP2), J16.11, J16.13 (MP), J16.14 (MP), J17.5 (GND), J19.1, J19.12, J19.A1 (GND), J19.A12 (GND), J19.B1 (GND), J19.B12 (GND), J21.A1 (GND), J21.A12 (GND), J21.B1 (GND), J21.B12 (GND), J24.0, J24.6, J27.1, J28.C1 (GND), J28.MP1, J28.MP2, J28.MP4, J28.MP5, J28.MP6, J28.MP7, J32.4, J32.MP (MountPin), J33.4, J33.MP (MountPin), J36.1 (GND), JP1.1, JP2.1, K1.1, LS1.3, LS1.4, Q2.1 (S), Q3.1 (S), Q3.4 (S), Q4.1 (G), Q7.2 (S), Q8.2 (E), R12.2, R13.1, R24.1, R29.2, R70.2, R104.1, RN1.5 (R4.2), RN1.6 (R3.2), RN1.7 (R2.2), RN1.8 (R1.2), RN2.5 (R4.2), RN2.6 (R3.2), RN2.7 (R2.2), RN2.8 (R1.2), RN3.5 (R4.2), RN3.6 (R3.2), RN3.7 (R2.2), RN3.8 (R1.2), RN4.5 (R4.2), RN4.6 (R3.2), RN4.7 (R2.2), RN4.8 (R1.2), RN5.5 (R4.2), RN5.6 (R3.2), RN5.7 (R2.2), RN5.8 (R1.2), RN11.5 (R4.2), RN11.6 (R3.2), RN11.7 (R2.2), RN11.8 (R1.2), RN12.5 (R4.2), RN12.6 (R3.2), RN12.7 (R2.2), RN12.8 (R1.2), RN13.5 (R4.2), RN13.6 (R3.2), RN13.7 (R2.2), RN13.8 (R1.2), RN14.5 (R4.2), RN14.6 (R3.2), RN14.7 (R2.2), RN14.8 (R1.2), RN15.5 (R4.2), RN15.6 (R3.2), RN15.7 (R2.2), RN15.8 (R1.2), SW34.C, SW35.C, U1.4 (GND), U2.19 (TESTEN), U2.57 (GND), U3.8 (GND), U4.2 (GND), U5.1 (A0), U5.2 (A1), U5.3 (A2), U5.4 (GND), U6.1 (GND), U8.1, U8.3 (GND), U9.2 (DP4), U9.12 (GND), U10.8 (GND), U11.8 (GND), U12.8 (GND), U13.8 (GND), U14.8 (GND), U14.14 (SerialIn), U31.7 (GND), U32.1 (GND), U35.7 (GND), Y1.2, Y1.4, Y2.2, Y2.4
GP5: J24.5, R70.1, U2.7 (GPIO5)
GP6: J24.4, R70.2, U2.8 (GPIO6)
GP7: J19.10, U2.9 (GPIO7)
GP8: J19.9, U2.11 (GPIO8)
GP9: J19.8, U2.12 (GPIO9)
GP10: J19.7, U2.13 (GPIO10)
GP15: U2.18 (GPIO15)
GP28: J15.4, J19.6, U2.40 (GPIO28/ADC2)
GP29: J15.3, J19.5, U2.41 (GPIO29/ADC3)
GPIO: IC1.D1 (GPIO), J27.2
Hub_D+: D4.3 (I/O2), J19.A6 (D+), J19.B6 (D+), U9.10 (DP)
Hub_D-: D4.2 (I/O1), J19.A7 (D-), J19.B7 (D-), U9.9 (DM)
KB_D+: R3.1, U9.8 (DP1)
KB_D-: R4.1, U9.7 (DM1)
LCD_BL_BARE: JP4.1 (A), R63.2
LCD_BL_DIRECT: J36.8 (BL), JP4.2 (B), U2.35 (GPIO23)
LEDK: J15.2, R65.2
LED_3v: U2.37 (GPIO25), U8.2
LED_5v: D6.4 (DIN), J20.1, U8.4
LED_5v_L_OUT: D59.2 (DOUT)
MB1: J16.8
MB2: J16.7
MB3: J16.6
MOTION: U3.9 (MOTION)
Matrix_1_2: U10.14 (SerialIn), U11.9 (QH/MISO)
Matrix_3_4: U11.14 (SerialIn), U12.9 (QH/MISO)
Matrix_5_6: U12.14 (SerialIn), U13.9 (QH/MISO)
Matrix_7_8: U13.14 (SerialIn), U14.9 (QH/MISO)
Matrix_8_9: U14.9 (QH/MISO), U14.14 (SerialIn)
Matrix_Latch: Q7.3 (D), R61.1, U10.12 (Latch), U10.13 (SS/~PL), U11.12 (Latch), U11.13 (SS/~PL), U12.12 (Latch), U12.13 (SS/~PL), U13.12 (Latch), U13.13 (SS/~PL), U14.12 (Latch), U14.13 (SS/~PL)
unnamed: C2.1, C92.1, F1.1, IC4.1 (OUT), IC5.1 (OUT)
unnamed: C2.2, R8.1
unnamed: C3.2, U2.20 (XTAL_IN), Y1.3
unnamed: C4.2, R5.1, R24.1, U2.30 (GPIO19), U3.10 (SCLK), Y1.1
unnamed: C8.1, D5.1 (K), R1.2, R9.2
unnamed: C9.1, U9.13 (VDD33), U9.14 (VDD18)
unnamed: C11.1, C14.1, U3.3 (VDDPIX)
unnamed: C13.1, R24.1, R104.2
unnamed: C13.2, R24.1
unnamed: C19.1, R24.1, U2.43 (ADC_AVDD)
unnamed: C34.1, C37.1, Q3.5 (G), R27.2, R28.1
unnamed: C35.1, U32.2 (C1), U32.3 (CSEL)
unnamed: C171.1, FB25.2, LS1.1
unnamed: C172.1, FB25.2, LS1.2
unnamed: D1.4 (VCC), F1.2, Q4.3 (D)
unnamed: D2.2 (A), R17.2
unnamed: D3.1 (K1), F1.1, J21.A4 (VBUS), J21.A9 (VBUS), J21.B4 (VBUS), J21.B9 (VBUS)
unnamed: D4.4 (VCC), F1.2, J19.A4 (VBUS), J19.A9 (VBUS), J19.B4 (VBUS), J19.B9 (VBUS), Q4.3 (D), U9.3 (DM3)
unnamed: D12.2 (DOUT), D30.4 (DIN)
unnamed: D12.4 (DIN), D38.2 (DOUT)
unnamed: D26.2 (DOUT), D27.4 (DIN)
unnamed: D6.2 (DOUT), D26.4 (DIN)
unnamed: D27.2 (DOUT), D28.4 (DIN)
unnamed: D28.2 (DOUT), D29.4 (DIN)
unnamed: D29.2 (DOUT), D31.4 (DIN)
unnamed: D30.2 (DOUT), D39.4 (DIN)
unnamed: D31.2 (DOUT), D32.4 (DIN)
unnamed: D32.2 (DOUT), D33.4 (DIN)
unnamed: D33.2 (DOUT), D34.4 (DIN)
unnamed: D34.2 (DOUT), D35.4 (DIN)
unnamed: D35.2 (DOUT), D36.4 (DIN)
unnamed: D36.2 (DOUT), D37.4 (DIN)
unnamed: D37.2 (DOUT), D38.4 (DIN)
unnamed: D39.2 (DOUT), D40.4 (DIN)
unnamed: D40.2 (DOUT), D43.4 (DIN)
unnamed: D43.2 (DOUT), D44.4 (DIN)
unnamed: D44.2 (DOUT), D45.4 (DIN)
unnamed: D45.2 (DOUT), D46.4 (DIN)
unnamed: D46.2 (DOUT), D47.4 (DIN)
unnamed: D47.2 (DOUT), D48.4 (DIN)
unnamed: D48.2 (DOUT), D49.4 (DIN)
unnamed: D49.2 (DOUT), D50.4 (DIN)
unnamed: D50.2 (DOUT), D51.4 (DIN)
unnamed: D51.2 (DOUT), D52.4 (DIN)
unnamed: D52.2 (DOUT), D53.4 (DIN)
unnamed: D53.2 (DOUT), D54.4 (DIN)
unnamed: D54.2 (DOUT), D55.4 (DIN)
unnamed: D55.2 (DOUT), D56.4 (DIN)
unnamed: D56.2 (DOUT), D57.4 (DIN)
unnamed: D57.2 (DOUT), D58.4 (DIN)
unnamed: D58.2 (DOUT), D59.4 (DIN)
unnamed: FB1.1, J21.S1 (SHIELD)
unnamed: FB1.2, J19.S1 (SHIELD)
unnamed: FB2.1, J19.S1 (SHIELD)
unnamed: FB14.1, J36.MP1
unnamed: FB15.1, J36.MP2
unnamed: FB16.1, J36.MP3
unnamed: FB17.1, J36.MP4
unnamed: FB25.1, U35.5 (OUT+), U35.8 (OUT-)
unnamed: IC4.5 (ISET), R70.1
unnamed: IC5.5 (ISET), R70.1
unnamed: IC6.5 (ISET), R70.1
unnamed: Q1.3 (G), R2.1, R3.2, R8.2
unnamed: Q2.3 (D), R27.1
unnamed: Q2.4 (S), Q2.5 (G), Q2.6 (D), Q3.2 (G), R23.2
unnamed: Q4.1 (G), U9.4 (DP3)
unnamed: Q8.1 (B), R63.1, R64.2
unnamed: Q8.3 (C), R65.1
unnamed: R1.2, R2.1
unnamed: R3.2, U2.47 (D+)
unnamed: R4.2, U2.46 (D-)
unnamed: R5.2, U2.21 (XTAL_OUT)
unnamed: R6.2, U3.15 (LED_P)
unnamed: R15.2, RN5.5 (R4.2), RN5.6 (R3.2), RN5.7 (R2.2), RN5.8 (R1.2)
unnamed: R21.2, U35.1 (~SD)
unnamed: R24.2, U10.9 (QH/MISO), U35.3 (IN+), U35.4 (IN-)
unnamed: R28.2, R29.1
unnamed: RN5.1 (R1.1), U31.1, U31.11, U32.11 (OUT4), U32.12 (OUT3)
unnamed: RN5.2 (R2.1), U31.5, U31.13, U32.10 (OUT5), U32.13 (OUT2)
unnamed: RN5.3 (R3.1), U31.3, U32.14 (OUT1)
unnamed: RN5.4 (R4.1), U31.9, U32.15 (OUT0)
unnamed: U9.15 (XOUT), Y2.1
unnamed: U9.16 (XIN), Y2.3
OUT+: IC2.A3 (OUT+), J18.1, TP4.1
OUT-: IC2.C3 (OUT-), J14.1, TP2.1
PS2_LMB: J24.3
PS2_MMB: J24.2
PS2_RMB: J24.1
PS2_RST: C19.1, J24.7, R13.2
P_DR: J16.4
Power_PDO2: D2.1 (K), IC1.A2 (POWER__OK2)
Power_PDO3: D2.1 (K), IC1.E1 (POWER__OK3)
QP_DC: J15.7, J36.6 (D/C), U2.28 (GPIO17)
QP_RST: J15.11, J36.5 (RST), U2.27 (GPIO16)
RESET: IC1.D4 (RESET), J27.4, R13.2
SCL: IC1.D5 (SCL), IC2.C1 (SCL), J15.1, J16.9, J19.3, R14.2, R18.2, U2.5 (GPIO3), U5.6 (SCL)
SDA: IC1.E5 (SDA), IC2.B2 (SDA), J15.2, J16.10, J19.4, R13.2, R20.1, U2.4 (GPIO2), U5.5 (SDA)
SPI_DISPLAY_CS: J15.8, J36.7 (CS), U2.34 (GPIO22)
SPI_MATRIX_CS: Q7.1 (G), U2.32 (GPIO21), U10.10 (OE/~CS), U11.10 (OE/~CS), U12.10 (OE/~CS), U13.10 (OE/~CS), U14.10 (OE/~CS)
SPI_MISO: C4.2, J16.2, R7.2, R24.1, U2.31 (GPIO20), U3.12 (MISO)
SPI_MOSI: J15.10, J16.5, J36.4 (MOSI), R24.2, U3.11 (MOSI)
SPI_POINTER_CS: J16.3, U2.17 (GPIO14), U3.13 (NCS)
SPI_SCK: J15.9, J16.1, J36.3 (SCK), R24.2, U2.29 (GPIO18), U10.11 (ShftClck/SCK), U11.11 (ShftClck/SCK), U12.11 (ShftClck/SCK), U13.11 (ShftClck/SCK), U14.11 (ShftClck/SCK)
SPLIT_HAND: R21.2, U2.6 (GPIO4)
SWCLK_L: J17.4 (SWDCLK/TCK), U2.24 (SWCLK)
SWDIO_L: J17.2 (SWDIO/TMS), U2.25 (SWDIO)
SWITCH: K1.2, Q2.2 (G), R22.2, TP5.1
TP0: J15.10, U32.4 (PAD0)
TP1: J15.9, U32.5 (PAD1)
TP2: J15.8, U32.6 (PAD2)
TP3: J15.7, U32.7 (PAD3)
TP4: J15.6, U32.8 (PAD4)
TP5: J15.5, U32.9 (PAD5)
TRIG: IC2.B1 (IN/TRIG), J12.1
VBUS_DETECT: R11.2, R12.1, U2.16 (GPIO13)
VBUS_EN_SINK: IC1.C1 (VBUS__EN_SNK), R3.1
VBUS_L: C1.1, C9.1, D1.1 (GND), D5.2 (A), IC1.A5 (VDD), J19.A4 (VBUS), J19.A9 (VBUS), J19.B4 (VBUS), J19.B9 (VBUS), J27.5, JP6.1 (A), Q1.4 (S), Q1.S, R2.2, R9.1, R11.1
VBUS_VS_DISCH: IC1.A1 (VBUS_VS__DISCH), R1.1
VDD_L: D81.C, R17.1
VREG_1v2: C11.1, IC1.A3 (VREG__1V2)
VREG_2v7: C10.2, D81.A, IC1.A4 (VREG__2V7)
VSINK_FUSED_L: C9.1, IC6.4 (EN), IC6.6 (IN), J19.11, Q4.2 (S), R21.2, U9.1 (DM4), U9.5 (DM2)
VSINK_L: C2.1, C9.1, D3.1 (K1), F1.1, IC4.4 (EN), IC4.6 (IN), IC5.4 (EN), IC5.6 (IN), JP6.2 (B), Q1.1 (D), Q1.2 (D), Q1.5 (D), Q1.6 (D), Q1.D, R21.2
k00: RN11.4 (R4.1), U10.15 (A), U31.6
k01: RN11.3 (R3.1), U10.1 (B), U31.4
k02: RN11.2 (R2.1), U10.2 (C), U31.2
k03: RN11.1 (R1.1), U10.3 (D), U31.8
k04: RN1.4 (R4.1), U10.4 (E), U31.10
k05: RN1.3 (R3.1), U10.5 (F), U31.12
k06: J33.1, RN1.2 (R2.1), U10.6 (G)
k07: J33.2, RN1.1 (R1.1), U10.7 (H)
k10: RN12.4 (R4.1), SW31.2, U11.15 (A)
k11: RN12.3 (R3.1), SW32.1, U11.1 (B)
k12: RN12.2 (R2.1), SW72.2, U11.2 (C)
k13: RN12.1 (R1.1), SW71.2, U11.3 (D)
k14: RN2.4 (R4.1), SW28.1, U11.4 (E)
k15: RN2.3 (R3.1), SW27.2, U11.5 (F)
k16: RN2.2 (R2.1), SW26.1, U11.6 (G)
k17: RN2.1 (R1.1), SW25.2, U11.7 (H)
k20: RN13.4 (R4.1), SW30.1, U12.15 (A)
k21: J28.E1 (NO), RN13.3 (R3.1), SW29.2, U12.1 (B)
k22: RN13.2 (R2.1), SW33.5 (D_RIGHT), U12.2 (C)
k23: RN13.1 (R1.1), SW33.6 (CENTER), U12.3 (D)
k24: RN3.4 (R4.1), SW33.3 (C_DOWN), U12.4 (E)
k25: RN3.3 (R3.1), SW33.2 (B_LEFT), U12.5 (F)
k26: RN3.2 (R2.1), SW33.1 (A_UP), U12.6 (G)
k27: RN3.1 (R1.1), SW35.3, U12.7 (H)
k30: RN14.4 (R4.1), SW21.2, U13.15 (A)
k31: RN14.3 (R3.1), SW17.1, U13.1 (B)
k32: RN14.2 (R2.1), SW22.2, U13.2 (C)
k33: RN14.1 (R1.1), SW18.1, U13.3 (D)
k34: RN4.4 (R4.1), SW23.2, U13.4 (E)
k35: RN4.3 (R3.1), SW19.1, U13.5 (F)
k36: RN4.2 (R2.1), SW24.2, U13.6 (G)
k37: RN4.1 (R1.1), SW20.1, U13.7 (H)
k40: RN15.4 (R4.1), SW12.2, U14.15 (A)
k41: RN15.3 (R3.1), SW16.2, U14.1 (B)
k42: RN15.2 (R2.1), SW11.2, U14.2 (C)
k43: RN15.1 (R1.1), SW15.2, U14.3 (D)
k44: RN5.4 (R4.1), SW10.2, U14.4 (E)
k45: RN5.3 (R3.1), SW14.2, U14.5 (F)
k46: RN5.2 (R2.1), SW9.2, U14.6 (G)
k47: RN5.1 (R1.1), SW13.2, U14.7 (H)
k50: RN15.4 (R4.1), SW8.1, U14.15 (A)
k51: RN15.3 (R3.1), SW4.2, U14.1 (B)
k52: RN15.2 (R2.1), SW3.2, U14.2 (C)
k53: RN15.1 (R1.1), SW7.1, U14.3 (D)
k54: RN5.4 (R4.1), SW2.2, U14.4 (E)
k55: RN5.3 (R3.1), SW6.1, U14.5 (F)
k56: RN5.2 (R2.1), SW1.2, U14.6 (G)
k57: RN5.1 (R1.1), SW5.1, U14.7 (H)
nRST: J17.3 (~RESET), Q3.6 (D), R26.2, TP6.1, U2.26 (~RUN)

Notes on the sheet:
PWM3B
Reset and bootloader
Trackball sensor
FLASH
Power track from central split should be connnected before the load switch and after the ideal mosfeft- opamp combo.
GP7 to 10, 15 - load switch monitoring
Trackpoint
RC Delay circuit, values can be tweaked as required
Split hand pin
*Supports bare screen GC9A01 and the square breakout version which gives access to the BL pin. Solder the jumper if using the bare screen.
SWD
Voltage rating: 20V Current rating: 5A
Q2A - pulls nRST to GND
V_{IN} 3 to 5.5v
I_{LIMIT} = 1,000 mA
LDO
RP2040
5v Load Switch
*Add an LRA or ERM motor.
Display
PWM5 A
(Taken from the Sea Picro)
AP22615 Features Fast short-circuit and output over-voltage response Reverse current blocking, over-current, over-temperature short-circuit protection Controlled rise-time and under-voltage lock-out
Tap for 500ms to reset Hold for 2 seconds to enter UF2 bootloader
SPI Termination Resistors Using 0805 in case I need to change them.
PWM4 A
Q2A - inverter, as button can only pull to ground due to being backwards compatiable
Extra breakouts
Split Comms
AUDIO
USB Hub
Since this is a proto board, I need a way to still use it if I mess up :D. Hence, the PD power path and backup DNP CC resistors
Barrier Diode
TVS Diode.
1kΩ@100MHz
Left the piezo buzzer footprint in case of amp and magnetic buzzer unavailability.
Net ties were used to set different trace widths and spacing for for the WLCSP components.
RGB
I_{LIMIT} using R4.7k = 1,446.80
PWM7 B
TVS diode to protect VBUS against EOS and ESD.
Power LED
Q2B - using body diode due to lack of space. Can sub with normal diode
PS/2
*Remove R1 for i2c use
Max input voltage 20v (15v recommended). Low dropout voltage 1.15v at 1A output current.
i2c FRAM EEPROM
Q3B Pulls NCS to GND
TVS diode against EOS and ESD transients
i2c PULLUPS
RGB level shift
6V 2A
Haptic Feedback
Cirque FFC
USB PD
USB
