freznel10/Chunky2040_rev2/(notices)

Notices in the files:
Left2040.kicad_sch:
Copyright 2023
